JustinVerkade/TMC6300-TinyHALL/TMC6300_HAL/Ordering/TMC6300_HALL_BOM.xlsx

Sheet: Sheet1
Name | Description | Qty | Link
STM32L431KBU6 | Microcontroller | 1 | https://nl.mouser.com/ProductDetail/STMicroelectronics/STM32L431KBU6?qs=U58vgkJzipSSkpDs8ltE9g%3D%3D
TMC6300-LA-T | BLDC driver | 1 | https://nl.mouser.com/ProductDetail/ADI-Trinamic/TMC6300-LA-T?qs=TiOZkKH1s2SPDan6zA6fKg%3D%3D
150060AS75000 | LED | 4 | https://nl.mouser.com/ProductDetail/Wurth-Elektronik/150060AS75000?qs=d0WKAl%252BL4KbvMBYryeof0Q%3D%3D
BLM15AX102SZ1D | Ferrite bead 1kOhm | 1 | https://nl.mouser.com/ProductDetail/Murata-Electronics/BLM15AX102SZ1D?qs=lEfY3O89Aqnho9IqRYLNSw%3D%3D
PTVS12VS1UR,115 | TVS diode 12V | 1 | https://nl.mouser.com/ProductDetail/Nexperia/PTVS12VS1UR115?qs=LMSg3oBIm%2FiWSHvsyxWiLg%3D%3D
VLS3015CX-4R7M-1 | Buck inductor 4.7u | 2 | https://nl.mouser.com/ProductDetail/TDK/VLS3015CX-4R7M-1?qs=gZXFycFWdANzf31QH9GBWA%3D%3D
MP1479GTF-P | Buck converter | 2 | https://nl.mouser.com/ProductDetail/Monolithic-Power-Systems-MPS/MP1479GTF-P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
ESD9X12ST5G | TVS diode 12V | 3 | https://nl.mouser.com/ProductDetail/onsemi/ESD9X12ST5G?qs=OSf9jACorvYeEtLjAfCdrQ%3D%3D
SZESD8351P2T5G | TVS diode 3.3V | 3 | https://nl.mouser.com/ProductDetail/onsemi/SZESD8351P2T5G?qs=dbuNSGnowt0hk7yUFmffJA%3D%3D
20021121-00006T4LF | Programming header | 1 | https://nl.mouser.com/ProductDetail/Amphenol-FCI/20021121-00006T4LF?qs=oJs1R%252BxK6kTRYpFukouk8Q%3D%3D
SZESD9101P2T5G | TVS diode 5V | 1 | https://nl.mouser.com/ProductDetail/onsemi/SZESD9101P2T5G?qs=5aG0NVq1C4yTUV3vL3eSQg%3D%3D
TLV8541DBVR | Opamp | 1 | https://nl.mouser.com/ProductDetail/Texas-Instruments/TLV8541DBVR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
B8B-PH-K-S(LF)(SN) | Connector motor | 1 | https://nl.rs-online.com/web/p/pcb-headers/8201444
B2B-PH-K-S(LF)(SN) | Connector power | 1 | https://nl.rs-online.com/web/p/pcb-headers/8201422
B3B-PH-K-S(LF)(SN) | Connector command | 1 | https://nl.rs-online.com/web/p/pcb-headers/8201431
PHR-8 | Connector female motor | 0 | https://nl.rs-online.com/web/p/wire-housings-plugs/8201488
PHR-2 | Connector female power | 0 | https://nl.rs-online.com/web/p/wire-housings-plugs/8201466
PHR-3 | Connector female command | 0 | https://nl.rs-online.com/web/p/wire-housings-plugs/8201475
SPH-002T-P0.5S | Connector female inserts | 0 | https://nl.rs-online.com/web/p/crimp-contacts/1235948
C1005X7R1C104K050BC | Capacitor 0402 100n | 14 | https://nl.mouser.com/ProductDetail/TDK/C1005X7R1C104K050BC?qs=NRhsANhppD%252BhAGOapA8QKQ%3D%3D
CL21A226MAYNNNE | Capacitor 0805 22u | 4 | https://nl.mouser.com/ProductDetail/Samsung-Electro-Mechanics/CL21A226MAYNNNE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
TMK107BJ105KA-T | Capacitor 0603 1u | 2 | https://nl.mouser.com/ProductDetail/TAIYO-YUDEN/TMK107BJ105KA-T?qs=PzICbMaShUeN5muIUMy52A%3D%3D
GRM21BC71E106KE01K | Capacitor 0805 10u | 5 | https://nl.mouser.com/ProductDetail/Murata-Electronics/GRM21BC71E106KE01K?qs=By6Nw2ByBD2m3JOqf4AY1Q%3D%3D
CL10A225KO8NNNC | Capacitor 0603 2.2u | 2 | https://nl.mouser.com/ProductDetail/Samsung-Electro-Mechanics/CL10A225KO8NNNC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
GRM155C81E105KE11J | Capacitor 0402 1u | 1 | https://nl.mouser.com/ProductDetail/Murata-Electronics/GRM155C81E105KE11J?qs=hNud%2FORuBR0msnbqee6%2FPw%3D%3D
AF0402JR-07220RL | Resistor 0402 220 | 4 | https://nl.mouser.com/ProductDetail/YAGEO/AF0402JR-07220RL?qs=Ghq3E7L6HNfV8BjGdjwaqw%3D%3D
ERJ-6DSFR12V | Resistor 0805 120m | 1 | https://nl.mouser.com/ProductDetail/Panasonic/ERJ-6DSFR12V?qs=WO7YBshssFF0LlAZA3Tj0Q%3D%3D
RC0402FR-072K2P | Resistor 0402 2.2k | 7 | https://nl.mouser.com/ProductDetail/YAGEO/RC0402FR-072K2P?qs=oypCK0zG3263%2FFJJTa4fIg%3D%3D
RC0402FR-7D100KL | Resistor 0402 100k | 11 | https://nl.mouser.com/ProductDetail/YAGEO/RC0402FR-7D100KL?qs=F5EMLAvA7IBe5AeajP0LKQ%3D%3D
RC0402FR-0713KL | Resistor 0402 13k | 2 | https://nl.mouser.com/ProductDetail/YAGEO/RC0402FR-0713KL?qs=sxZXDnvRBEhPjc%252B9C6HVrA%3D%3D
RC0402FR-0740K2L | Resistor 0402 40.2k | 3 | https://nl.mouser.com/ProductDetail/YAGEO/RC0402FR-0740K2L?qs=UOUeRUa%252B8Wn56bwc3oChog%3D%3D
RC0402FR-077K68L | Resistor 0402 7.68k | 1 | https://nl.mouser.com/ProductDetail/YAGEO/RC0402FR-077K68L?qs=Is6ZsIPfHkasmjGY7J9QlA%3D%3D
AC0402FR-7W47KL | Resistor 0402 47k | 2 | https://nl.mouser.com/ProductDetail/YAGEO/AC0402FR-7W47KL?qs=mQk0km4IMDeu%252BLYkO5whnw%3D%3D
RC0402JR-0710RP | Resistor 0402 10 | 2 | https://nl.mouser.com/ProductDetail/YAGEO/RC0402JR-0710RP?qs=oypCK0zG324s%252BbbL7ccvUA%3D%3D
RT0402FRE07649RL | Resistor 0402 649 | 4 | https://nl.mouser.com/ProductDetail/YAGEO/RT0402FRE07649RL?qs=sGAEpiMZZMvdGkrng054t98Xz4DA4UW4bL7f7IZrCXc%3D
ERJ-2RKF2702X | Resistor 0402 27k | 1 | https://nl.mouser.com/ProductDetail/Panasonic/ERJ-2RKF2702X?qs=YMBIwoNQYdVjy3UL%2FjeFIg%3D%3D
 |  | 90

Sheet: Sheet2
STM32L431KBU6 | 1
TMC6300-LA-T | 1
150060AS75000 | 4
BLM15AX102SZ1D | 1
PTVS12VS1UR,115 | 1
VLS3015CX-4R7M-1 | 2
MP1479GTF-P | 2
ESD9X12ST5G | 3
SZESD8351P2T5G | 3
20021121-00006T4LF | 1
SZESD9101P2T5G | 1
TLV8541DBVR | 1
C1005X7R1C104K050BC | 14
CL21A226MAYNNNE | 4
TMK107BJ105KA-T | 2
GRM21BC71E106KE01K | 5
CL10A225KO8NNNC | 2
GRM155C81E105KE11J | 1
AF0402JR-07220RL | 4
ERJ-6DSFR12V | 1
RC0402FR-072K2P | 7
RC0402FR-7D100KL | 11
RC0402FR-0713KL | 2
RC0402FR-0740K2L | 3
RC0402FR-077K68L | 1
AC0402FR-7W47KL | 2
RC0402JR-0710RP | 2
RT0402FRE07649RL | 4
ERJ-2RKF2702X | 1
