JustinVerkade/TMC6300-TinyHALL/TMC6300_HAL/TMC6300_HAL.kicad_pcb

## KiCad design TMC6300_HAL/TMC6300_HAL.kicad_pcb (2024-11-14)

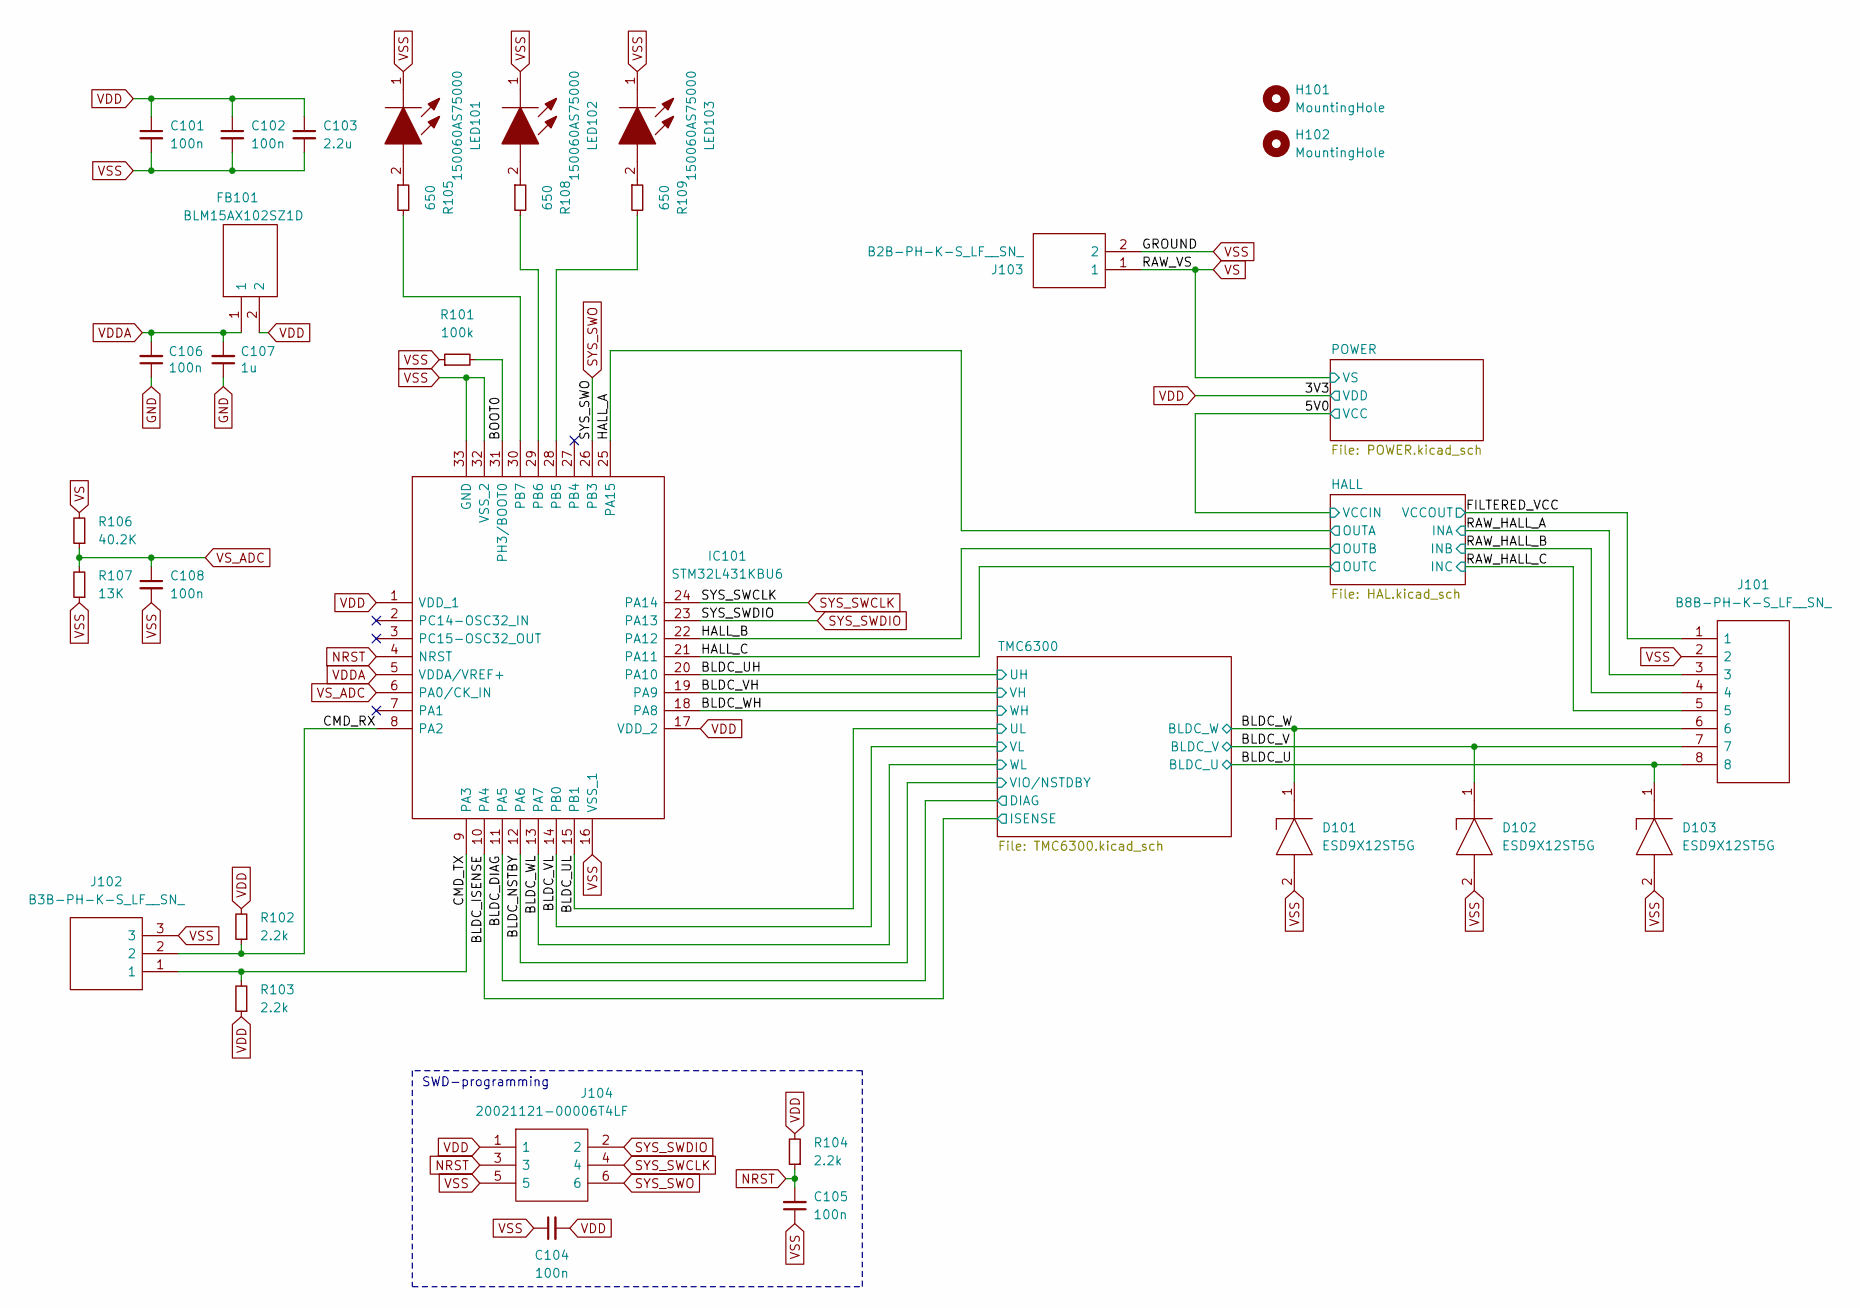
[picture p1: schematic TMC6300_HAL.kicad_sch]

Parts:
C101, C102, C104, C105, C106, C108: 100n; C_0402_1005Metric
C103: 2.2u; C_0603_1608Metric
C107: 1u; C_0402_1005Metric
D101, D102, D103: ESD9X12ST5G; SODFL1006X40N; Mouser Part Number 863-ESD9X12ST5G
FB101: BLM15AX102SZ1D; NFZ15SG152SN10B; Mouser Part Number 81-BLM15AX102SZ1D
H101, H102: MountingHole; MountingHole_3.2mm_M3
IC101: STM32L431KBU6; QFN50P500X500X60-33N-D; Mouser Part Number 511-STM32L431KBU6
J101: B8B-PH-K-S_LF__SN_; B8BPHKSLFSN; Manufacturer_Part_Number B8B-PH-K-S(LF)(SN)
J102: B3B-PH-K-S_LF__SN_; SHDR3W50P0X200_1X3_790X450X600P; Manufacturer_Part_Number B3B-PH-K-S(LF)(SN)
J103: B2B-PH-K-S_LF__SN_; SHDR2W50P0X200_1X2_590X450X600P; Manufacturer_Part_Number B2B-PH-K-S(LF)(SN)
J104: 20021121-00006T4LF; HUSSP6W41P127_2X3_381X343X440P; Mouser Part Number 649-221121-00006T4LF
LED101, LED102, LED103: 150060AS75000; LEDC1608X80N; Mouser Part Number 710-150060AS75000
R101: 100k; R_0402_1005Metric
R102, R103, R104: 2.2k; R_0402_1005Metric
R105, R108, R109: 650; R_0402_1005Metric
R106: 40.2K; R_0402_1005Metric
R107: 13K; R_0402_1005Metric

Connections:
/5V0: J101.1; also elsewhere on the board
/BLDC_DIAG: IC101.11 (PA5); also elsewhere on the board
/BLDC_ISENSE: IC101.10 (PA4); also elsewhere on the board
/BLDC_NSTBY: IC101.12 (PA6); also elsewhere on the board
/BLDC_U: D103.1, J101.8; also elsewhere on the board
/BLDC_UH: IC101.20 (PA10); also elsewhere on the board
/BLDC_UL: IC101.15 (PB1); also elsewhere on the board
/BLDC_V: D102.1, J101.7; also elsewhere on the board
/BLDC_VH: IC101.19 (PA9); also elsewhere on the board
/BLDC_VL: IC101.14 (PB0); also elsewhere on the board
/BLDC_W: D101.1, J101.6; also elsewhere on the board
/BLDC_WH: IC101.18 (PA8); also elsewhere on the board
/BLDC_WL: IC101.13 (PA7); also elsewhere on the board
/BOOT0: IC101.31 (PH3/BOOT0), R101.2
/CMD_RX: IC101.8 (PA2), J102.2, R102.1
/CMD_TX: IC101.9 (PA3), J102.1, R103.2
/HALL_A: IC101.25 (PA15); also elsewhere on the board
/HALL_B: IC101.22 (PA12); also elsewhere on the board
/HALL_C: IC101.21 (PA11); also elsewhere on the board
/RAW_HALL_A: J101.3; also elsewhere on the board
/RAW_HALL_B: J101.4; also elsewhere on the board
/RAW_HALL_C: J101.5; also elsewhere on the board
GND: C106.1, C107.1
NRST: C105.2, IC101.4 (NRST), J104.3, R104.1
unnamed: IC101.28 (PB5), R109.2
unnamed: IC101.29 (PB6), R108.2
unnamed: IC101.30 (PB7), R105.2
unnamed: LED101.2, R105.1
unnamed: LED102.2, R108.1
unnamed: LED103.2, R109.1
SYS_SWCLK: IC101.24 (PA14), J104.4
SYS_SWDIO: IC101.23 (PA13), J104.2
SYS_SWO: IC101.26 (PB3), J104.6
VDD: C101.1, C102.1, C103.1, C104.2, FB101.2, IC101.1 (VDD_1), IC101.17 (VDD_2), J104.1, R102.2, R103.1, R104.2; also elsewhere on the board
VDDA: C106.2, C107.2, FB101.1, IC101.5 (VDDA/VREF+)
VS: J103.1, R106.2; also elsewhere on the board
VSS: C101.2, C102.2, C103.2, C104.1, C105.1, C108.2, D101.2, D102.2, D103.2, IC101.16 (VSS_1), IC101.32 (VSS_2), IC101.33 (GND), J101.2, J102.3, J103.2, J104.5, LED101.1, LED102.1, LED103.1, R101.1, R107.1; also elsewhere on the board
VS_ADC: C108.1, IC101.6 (PA0/CK_IN), R106.1, R107.2

Notes on the sheet:
SWD-programming

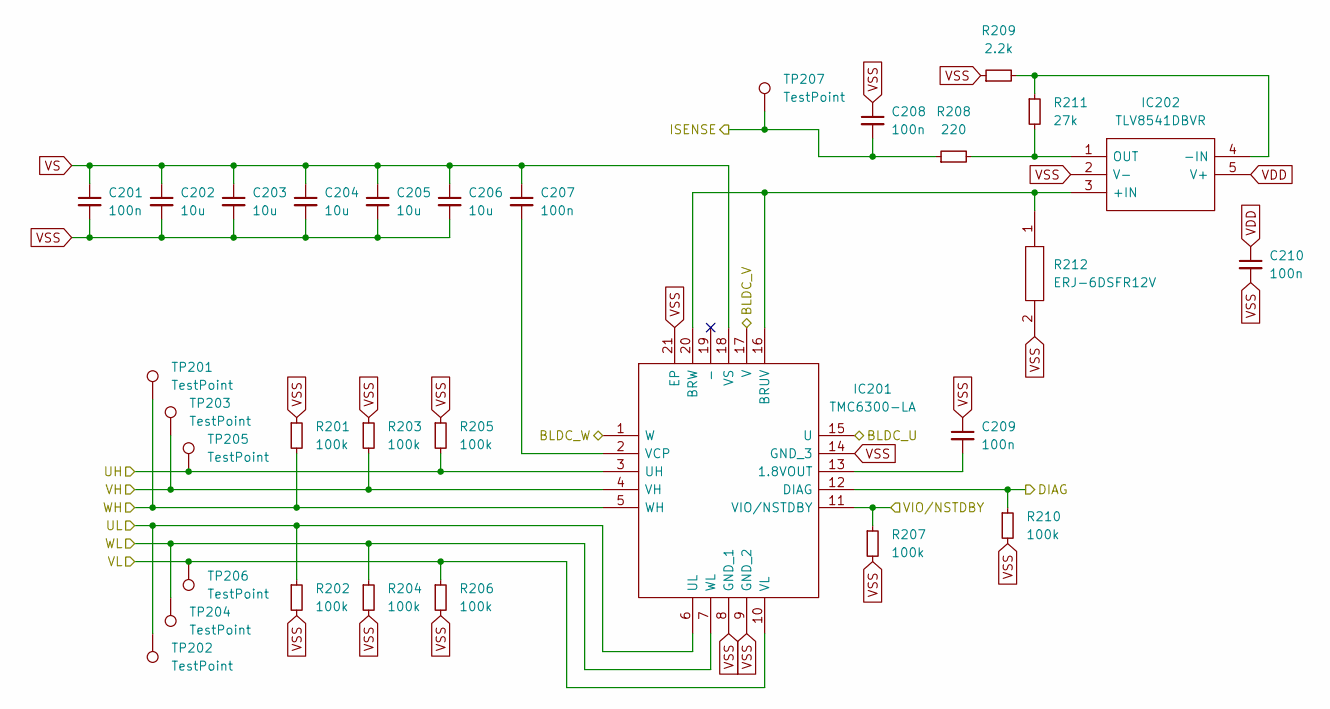
[picture p2: schematic TMC6300.kicad_sch]

Parts:
C201, C207, C208, C209, C210: 100n; C_0402_1005Metric
C202, C203, C204, C205, C206: 10u; C_0805_2012Metric
IC201: TMC6300-LA; QFN40P300X300X90-21N; Mouser Part Number 700-TMC6300-LA
IC202: TLV8541DBVR; SOT95P280X145-5N; Mouser Part Number 595-TLV8541DBVR
R201, R202, R203, R204, R205, R206, R207, R210: 100k; R_0402_1005Metric
R208: 220; R_0402_1005Metric
R209: 2.2k; R_0402_1005Metric
R211: 27k; R_0402_1005Metric
R212: ERJ-6DSFR12V; ERJ6_B_BW_R_LW_CW_D; Mouser Part Number 667-ERJ-6DSFR12V
TP201, TP202, TP203, TP204, TP205, TP206, TP207: TestPoint; TestPoint_Pad_D1.0mm

Connections:
/BLDC_DIAG: IC201.12 (DIAG), R210.1; also elsewhere on the board
/BLDC_ISENSE: C208.2, R208.1, TP207.1; also elsewhere on the board
/BLDC_NSTBY: IC201.11 (VIO/NSTDBY), R207.1; also elsewhere on the board
/BLDC_U: IC201.15 (U); also elsewhere on the board
/BLDC_UH: IC201.3 (UH), R205.2, TP205.1; also elsewhere on the board
/BLDC_UL: IC201.6 (UL), R202.1, TP202.1; also elsewhere on the board
/BLDC_V: IC201.17 (V); also elsewhere on the board
/BLDC_VH: IC201.4 (VH), R203.2, TP203.1; also elsewhere on the board
/BLDC_VL: IC201.10 (VL), R206.1, TP206.1; also elsewhere on the board
/BLDC_W: IC201.1 (W); also elsewhere on the board
/BLDC_WH: IC201.5 (WH), R201.2, TP201.1; also elsewhere on the board
/BLDC_WL: IC201.7 (WL), R204.1, TP204.1; also elsewhere on the board
unnamed: C209.2, IC201.13 (1.8VOUT)
unnamed: IC201.16 (BRUV), IC201.20 (BRW), IC202.3 (+IN), R212.1
unnamed: C207.2, IC201.2 (VCP)
unnamed: IC202.4 (-IN), R209.2, R211.1
unnamed: IC202.1 (OUT), R208.2, R211.2
VDD: C210.1, IC202.5 (V+); also elsewhere on the board
VS: C201.1, C202.1, C203.1, C204.1, C205.1, C206.1, C207.1, IC201.18 (VS); also elsewhere on the board
VSS: C201.2, C202.2, C203.2, C204.2, C205.2, C206.2, C208.1, C209.1, C210.2, IC201.8 (GND_1), IC201.9 (GND_2), IC201.14 (GND_3), IC201.21 (EP), IC202.2 (V-), R201.1, R202.2, R203.1, R204.2, R205.1, R206.2, R207.2, R209.1, R210.2, R212.2; also elsewhere on the board

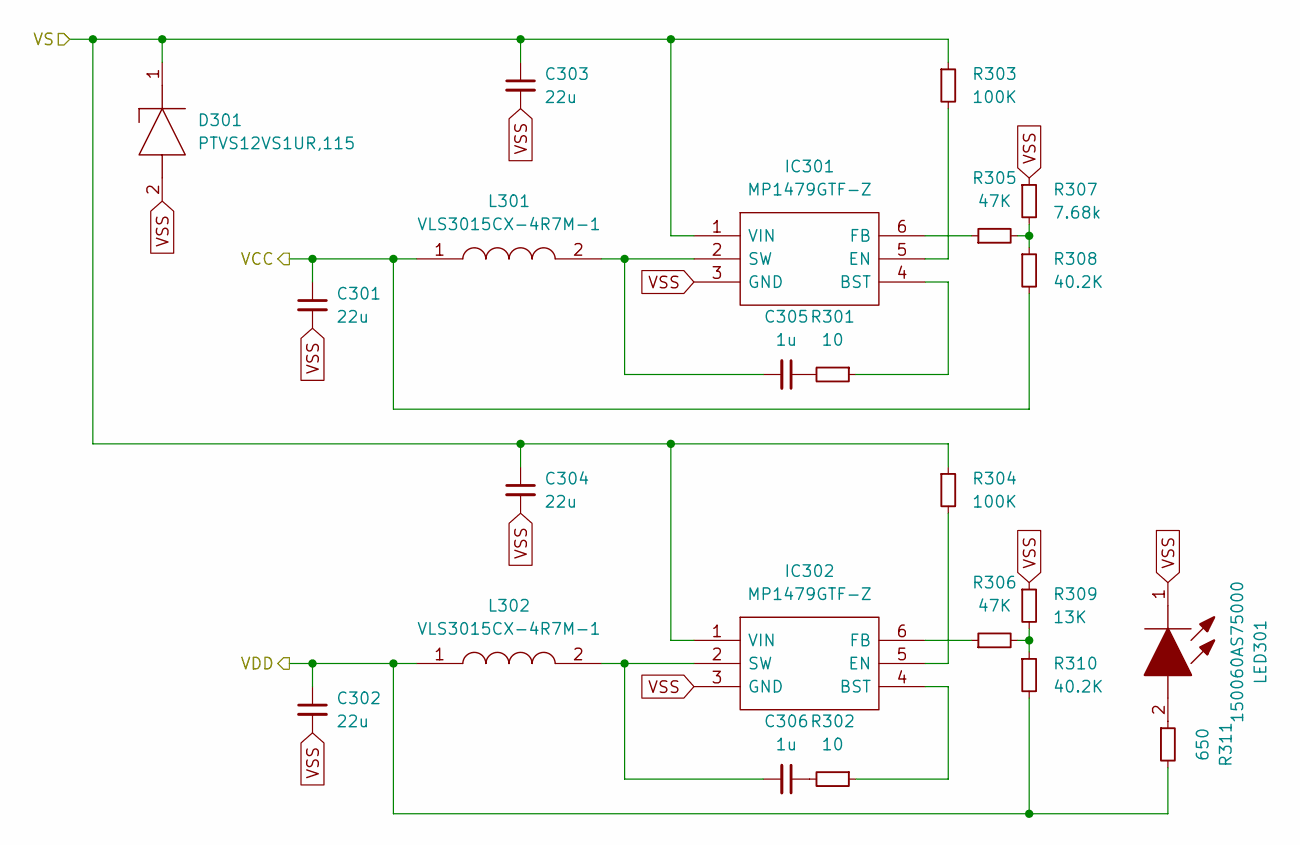
[picture p3: schematic POWER.kicad_sch]

Parts:
C301, C302, C303, C304: 22u; C_0805_2012Metric
C305, C306: 1u; C_0603_1608Metric
D301: PTVS12VS1UR,115; SOD123W; Mouser Part Number 771-PTVS12VS1UR115
IC301, IC302: MP1479GTF-Z; MP1479GTFZ; Mouser Part Number 946-MP1479GTF-Z
L301, L302: VLS3015CX-4R7M-1; VLS3015; Manufacturer_Part_Number VLS3015CX-4R7M-1; Mouser Part Number 810-VLS3015CX-4R7M-1
LED301: 150060AS75000; LEDC1608X80N; Mouser Part Number 710-150060AS75000
R301, R302: 10; R_0402_1005Metric
R303, R304: 100K; R_0402_1005Metric
R305, R306: 47K; R_0402_1005Metric
R307: 7.68k; R_0402_1005Metric
R308, R310: 40.2K; R_0402_1005Metric
R309: 13K; R_0402_1005Metric
R311: 650; R_0402_1005Metric

Connections:
/5V0: C301.1, L301.1, R308.2; also elsewhere on the board
unnamed: C305.1, R301.2
unnamed: C306.1, R302.2
unnamed: IC301.4 (BST), R301.1
unnamed: IC301.5 (EN), R303.2
unnamed: IC301.6 (FB), R305.1
unnamed: C305.2, IC301.2 (SW), L301.2
unnamed: IC302.4 (BST), R302.1
unnamed: IC302.5 (EN), R304.2
unnamed: IC302.6 (FB), R306.1
unnamed: C306.2, IC302.2 (SW), L302.2
unnamed: LED301.2, R311.1
unnamed: R305.2, R307.2, R308.1
unnamed: R306.2, R309.2, R310.1
VDD: C302.1, L302.1, R310.2, R311.2; also elsewhere on the board
VS: C303.1, C304.1, D301.1, IC301.1 (VIN), IC302.1 (VIN), R303.1, R304.1; also elsewhere on the board
VSS: C301.2, C302.2, C303.2, C304.2, D301.2, IC301.3 (GND), IC302.3 (GND), LED301.1, R307.1, R309.1; also elsewhere on the board

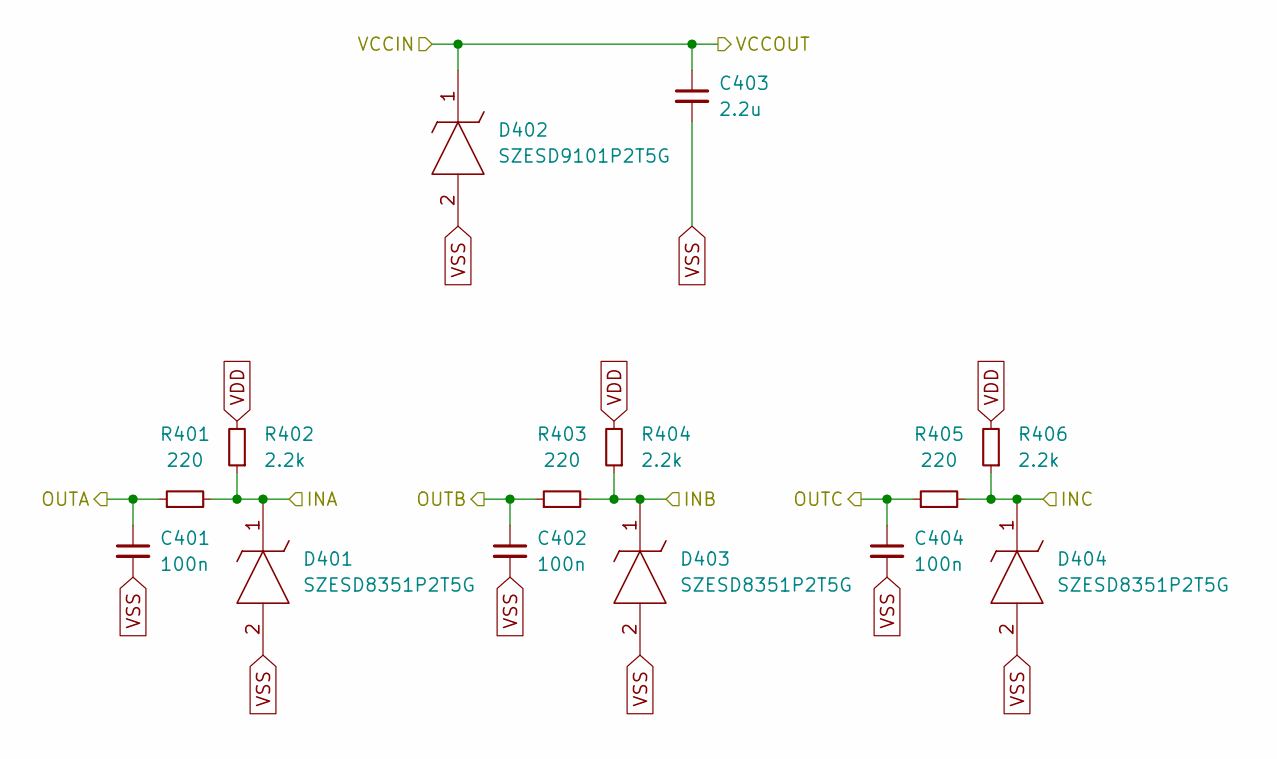
[picture p4: schematic HAL.kicad_sch]

Parts:
C401, C402, C404: 100n; C_0402_1005Metric
C403: 2.2u; C_0603_1608Metric
D401, D403, D404: SZESD8351P2T5G; SODFL1006X40N; Mouser Part Number 863-SZESD8351P2T5G
D402: SZESD9101P2T5G; SODFL1006X40N; Mouser Part Number 863-SZESD9101P2T5G
R401, R403, R405: 220; R_0402_1005Metric
R402, R404, R406: 2.2k; R_0402_1005Metric

Connections:
/5V0: C403.1, D402.1; also elsewhere on the board
/HALL_A: C401.1, R401.1; also elsewhere on the board
/HALL_B: C402.1, R403.1; also elsewhere on the board
/HALL_C: C404.1, R405.1; also elsewhere on the board
/RAW_HALL_A: D401.1, R401.2, R402.1; also elsewhere on the board
/RAW_HALL_B: D403.1, R403.2, R404.1; also elsewhere on the board
/RAW_HALL_C: D404.1, R405.2, R406.1; also elsewhere on the board
VDD: R402.2, R404.2, R406.2; also elsewhere on the board
VSS: C401.2, C402.2, C403.2, C404.2, D401.2, D402.2, D403.2, D404.2; also elsewhere on the board

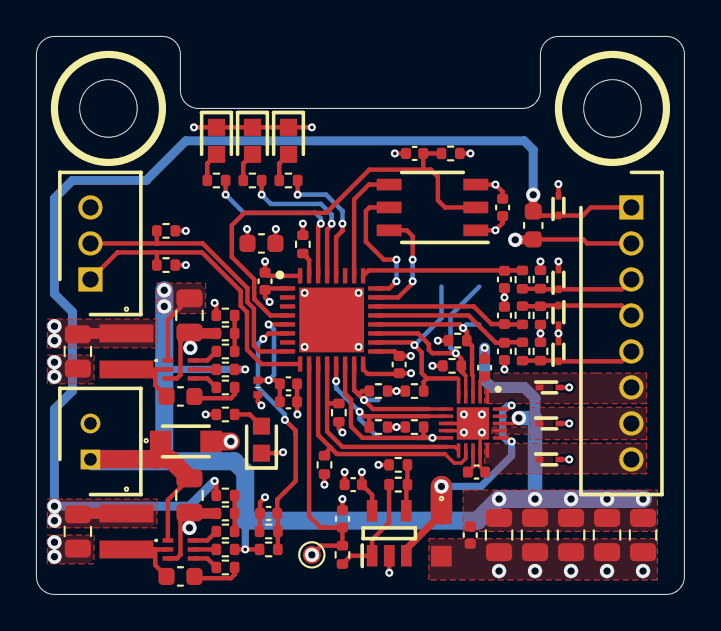
[picture p5: board TMC6300_HAL.kicad_pcb from above]

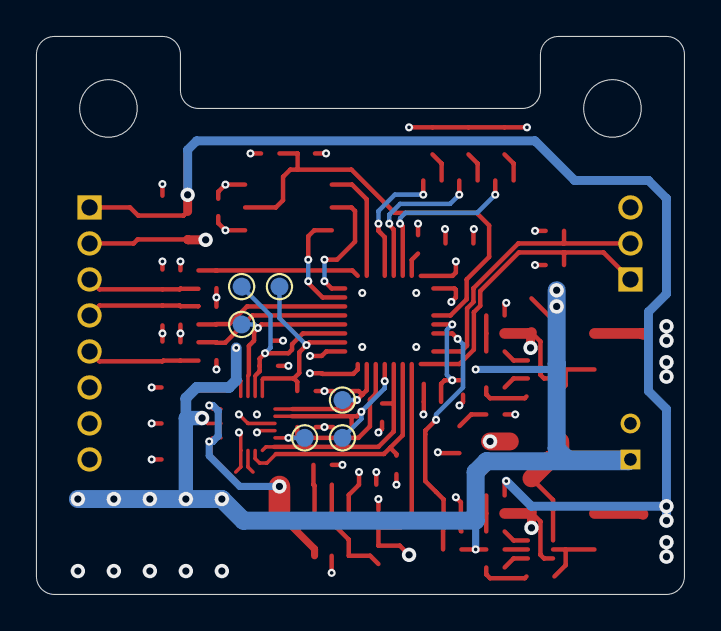
[picture p6: board TMC6300_HAL.kicad_pcb from below]

Board: 4 copper layers, 36.0 x 31.0 mm, 99 parts (6 on the bottom side), 56 nets.
