JustinVerkade/TMC6300-TinyHALL/Core/Src/main.c

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
/* Includes ------------------------------------------------------------------*/
#include "main.h"

/* USER CODE BEGIN Includes */
#include "uart_header.h"
#include "string.h"
#include "stdio.h"
#include "stdlib.h"
#include "math.h"

/* USER CODE END Includes */

ADC_HandleTypeDef hadc1;
DMA_HandleTypeDef hdma_adc1;

TIM_HandleTypeDef htim1;
TIM_HandleTypeDef htim2;

UART_HandleTypeDef huart2;

void SystemClock_Config(void);
static void MX_GPIO_Init(void);
static void MX_DMA_Init(void);
static void MX_ADC1_Init(void);
static void MX_TIM1_Init(void);
static void MX_USART2_UART_Init(void);
static void MX_TIM2_Init(void);
/* USER CODE BEGIN 0 */
int8_t direction = 0;			//     1  3  2  5  6  4
const uint8_t switch_sequence[8] = {0, 0, 2, 1, 4, 5, 3, 0};
const uint8_t pulse_sequence[8][3] = {{1, 0, 0}, {1, 0, 1}, {0, 0, 1}, {0, 1, 1}, {0, 1, 0}, {1, 1, 0}};

int32_t power = 500;
int32_t position = 0;
int32_t velocity = 0;
int32_t current = 0;
int32_t target_position = 0;
int32_t target_velocity = 12 * 100;
int32_t target_current = 0;

void setSequence()
{
	static uint8_t prev_seq_index = 0;
	uint8_t state_a = HAL_GPIO_ReadPin(HAL_A_GPIO_Port, HAL_A_Pin);
	uint8_t state_b = HAL_GPIO_ReadPin(HAL_B_GPIO_Port, HAL_B_Pin);
	uint8_t state_c = HAL_GPIO_ReadPin(HAL_C_GPIO_Port, HAL_C_Pin);
	uint8_t index = (state_c << 2) | (state_b << 1) | (state_a << 0);
	uint8_t seq_index = (switch_sequence[index] + 4 + direction * 2) % 6;

	if(switch_sequence[index] == (prev_seq_index + 1) % 6)
		position += 1;
	if(prev_seq_index == (switch_sequence[index] + 1) % 6)
		position -= 1;
	prev_seq_index = switch_sequence[index];

	htim1.Instance->CCR1 = pulse_sequence[seq_index][0] * power;
	htim1.Instance->CCR2 = pulse_sequence[seq_index][1] * power;
	htim1.Instance->CCR3 = pulse_sequence[seq_index][2] * power;
}


int32_t velocity_interval = 0;
void HAL_GPIO_EXTI_Callback(uint16_t GPIO_Pin)
{
	if(GPIO_Pin == HAL_A_Pin || GPIO_Pin == HAL_B_Pin || GPIO_Pin == HAL_C_Pin)
	{
		setSequence();
		velocity_interval = htim2.Instance->CNT;
		htim2.Instance->CNT = 0;
	}
}

void HAL_TIM_PeriodElapsedCallback(TIM_HandleTypeDef* htim)
{
	velocity_interval = -1;
}

uint8_t uart_receive_buffer[UART_PACKAGE_SIZE];
void HAL_UART_RxCpltCallback(UART_HandleTypeDef *huart)
{
	// send response
	UartResponsePackage_t package;
	package.response = UART_ACK;
	package.none0 = 0;
	package.none1 = 0;
	package.none2 = 0;
	package.none3 = 0;
	package.none4 = 0;
	package.none5 = 0;
	package.none6 = 0;
	package.none7 = 0;
	HAL_UART_Transmit_IT(&huart2, (uint8_t*)&package, UART_PACKAGE_SIZE);

	// restart interrupt
	HAL_UART_Receive_IT(&huart2, (uint8_t*)&uart_receive_buffer, UART_PACKAGE_SIZE);
}


uint32_t adc_buffer[2];
uint32_t adc_dma_buffer[2];
void HAL_ADC_ConvCpltCallback(ADC_HandleTypeDef* hadc)
{
	// filter and insert data
	adc_buffer[0] = (adc_buffer[0] * 253 + adc_dma_buffer[0] * 3) >> 8;
	adc_buffer[1] = (adc_buffer[1] * 253 + adc_dma_buffer[1] * 3) >> 8;

	// current regulation loop
	HAL_ADC_Start_DMA(&hadc1, adc_dma_buffer, 2);
}


/* USER CODE END 0 */

/**
 * @brief  The application entry point.
 * @retval int
 */
int main(void)
{
	/* MCU Configuration--------------------------------------------------------*/

	/* Reset of all peripherals, Initializes the Flash interface and the Systick. */
	HAL_Init();

	/* Configure the system clock */
	SystemClock_Config();

	/* Initialize all configured peripherals */
	MX_GPIO_Init();
	MX_DMA_Init();
	MX_ADC1_Init();
	MX_TIM1_Init();
	MX_USART2_UART_Init();
	MX_TIM2_Init();
	/* USER CODE BEGIN 2 */

	htim1.Instance->CCR1 = 500;
	htim1.Instance->CCR2 = 500;
	htim1.Instance->CCR3 = 500;

	htim1.Instance->CR2 &= ~(TIM_CR2_CCPC);
	HAL_TIM_Base_Start(&htim1);
	HAL_TIM_PWM_Start(&htim1, TIM_CHANNEL_1);
	HAL_TIMEx_PWMN_Start(&htim1, TIM_CHANNEL_1);
	HAL_TIM_PWM_Start(&htim1, TIM_CHANNEL_2);
	HAL_TIMEx_PWMN_Start(&htim1, TIM_CHANNEL_2);
	HAL_TIM_PWM_Start(&htim1, TIM_CHANNEL_3);
	HAL_TIMEx_PWMN_Start(&htim1, TIM_CHANNEL_3);

	// start interrupt
	HAL_UART_Receive_IT(&huart2, (uint8_t*)&uart_receive_buffer, UART_PACKAGE_SIZE);

	// start adc
	HAL_ADC_Start_DMA(&hadc1, adc_dma_buffer, 2);
	HAL_TIM_Base_Start_IT(&htim2);

	char tx_buffer[32];
	sprintf(tx_buffer, "current(mA), velocity(n/s), position(n)\n");
	HAL_UART_Transmit_IT(&huart2, (uint8_t*)tx_buffer, strlen(tx_buffer));

	/* USER CODE END 2 */

	/* Infinite loop */
	/* USER CODE BEGIN WHILE */
	while (1)
	{
		static uint32_t current_loop = 100;
		if(current_loop < HAL_GetTick())
		{
			current_loop = HAL_GetTick() + 5;

			// get milliamp count
			int32_t millivolt = (int32_t)(3300 * adc_buffer[1] / 4096);
			current = direction * millivolt / 1.5924f;

			// PI controller
			int32_t error = target_current - current;

			int32_t proportional = error * 64;

			static int32_t integral = 0;
			integral += error * 32;
			integral = integral > 512000 ? 512000 : integral;
			integral = integral <-512000 ?-512000 : integral;

			int32_t output = proportional / 256 + integral / 256;
			output = output > 2000 ? 2000 : output;
			output = output <-2000 ?-2000 : output;

			direction = output > 0 ? 1 : -1;
			power = labs(output);

			if(velocity <= 5 && velocity >= -5)
				setSequence();
		}

		static uint32_t velocity_loop = 100;
		if(velocity_loop < HAL_GetTick())
		{
			velocity_loop = HAL_GetTick() + 10;

			// get velocity count
			static int32_t prev_position = 0;
			int32_t dir = position - prev_position;
			prev_position = position;
			dir = dir > 1 ? 1 : dir;
			dir = dir < -1 ? -1 : dir;

			int32_t raw_velocity = dir * 20000000l / velocity_interval;
			if(velocity_interval == -1)
				raw_velocity = 0;
			velocity = (velocity * 150 + raw_velocity * 106) >> 8;

			// PI controller
			int32_t error = target_velocity - velocity;

			int32_t proportional = error * 800;

			static int32_t integral = 0;
			integral += error * 48;
			integral = integral > 256000 ? 256000 : integral;
			integral = integral <-256000 ?-256000 : integral;

			int32_t output = proportional / 256 + integral / 256;
			output = output > 1000 ? 1000 : output;
			output = output <-1000 ?-1000 : output;

			target_current = output;
		}

		static uint32_t position_loop = 100;
		if(position_loop < HAL_GetTick())
		{
			position_loop = HAL_GetTick() + 20;

			// PI controller
			int32_t error = target_position - position;

			int32_t proportional = error * 3200;

			static int32_t integral = 0;
			integral += error * 0;
			integral = integral > 307200 ? 307200 : integral;
			integral = integral <-307200 ?-307200 : integral;

			int32_t output = proportional / 256 + integral / 256;
			output = output > 1200 ? 1200 : output;
			output = output <-1200 ?-1200 : output;

			target_velocity = output;
		}

		// debug code
		static uint32_t debug = 100;
		if(debug < HAL_GetTick())
		{
			debug = HAL_GetTick() + 50;

			char tx_buffer[32];
			sprintf(tx_buffer, "%ld, %ld, %ld, %ld\n", current, velocity, position, target_position);
			HAL_UART_Transmit_IT(&huart2, (uint8_t*)tx_buffer, strlen(tx_buffer));
		}

		// switch code
		static uint32_t switch_loop = 100;
		if(switch_loop < HAL_GetTick())
		{
			switch_loop = HAL_GetTick() + 20;
			target_position = 600 * sinf((float)HAL_GetTick() / 1000.0f) + 200 * sinf(1.0f + (float)HAL_GetTick() / 700.0f);
		}


		/* USER CODE END WHILE */

		/* USER CODE BEGIN 3 */
	}
	/* USER CODE END 3 */
}

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
