JustinVerkade/TMC6300-TinyHALL/Core/Inc/main.h

#define VS_ADC_Pin GPIO_PIN_0
#define VS_ADC_GPIO_Port GPIOA
#define COMMAND_TX_Pin GPIO_PIN_2
#define COMMAND_TX_GPIO_Port GPIOA
#define COMMAND_RX_Pin GPIO_PIN_3
#define COMMAND_RX_GPIO_Port GPIOA
#define BLDC_ISENSE_Pin GPIO_PIN_4
#define BLDC_ISENSE_GPIO_Port GPIOA
#define BLDC_DIAG_Pin GPIO_PIN_5
#define BLDC_DIAG_GPIO_Port GPIOA
#define BLDC_NSTDBY_Pin GPIO_PIN_6
#define BLDC_NSTDBY_GPIO_Port GPIOA
#define BLDC_WL_Pin GPIO_PIN_7
#define BLDC_WL_GPIO_Port GPIOA
#define BLDC_VL_Pin GPIO_PIN_0
#define BLDC_VL_GPIO_Port GPIOB
#define BLDC_UL_Pin GPIO_PIN_1
#define BLDC_UL_GPIO_Port GPIOB
#define BLDC_WH_Pin GPIO_PIN_8
#define BLDC_WH_GPIO_Port GPIOA
#define BLDC_VH_Pin GPIO_PIN_9
#define BLDC_VH_GPIO_Port GPIOA
#define BLDC_UH_Pin GPIO_PIN_10
#define BLDC_UH_GPIO_Port GPIOA
#define HAL_C_Pin GPIO_PIN_11
#define HAL_C_GPIO_Port GPIOA
#define HAL_C_EXTI_IRQn EXTI15_10_IRQn
#define HAL_B_Pin GPIO_PIN_12
#define HAL_B_GPIO_Port GPIOA
#define HAL_B_EXTI_IRQn EXTI15_10_IRQn
#define HAL_A_Pin GPIO_PIN_15
#define HAL_A_GPIO_Port GPIOA
#define HAL_A_EXTI_IRQn EXTI15_10_IRQn
#define LED2_Pin GPIO_PIN_5
#define LED2_GPIO_Port GPIOB
#define LED1_Pin GPIO_PIN_6
#define LED1_GPIO_Port GPIOB
#define LED0_Pin GPIO_PIN_7
#define LED0_GPIO_Port GPIOB
