JustinVerkade/TMC6300-TinyHALL/(commit log)

2024-05-30 Version used with Lencon blower.
    [HAL.kicad_sch, POWER.kicad_sch, TMC6300.kicad_sch, TMC6300_HAL.kicad_pcb, TMC6300_HAL.kicad_sch]
2024-11-14 Cleanup local to github
    [HAL.kicad_sch, POWER.kicad_sch, TMC6300.kicad_sch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]
